NicholasUnruh/rv32i-pipeline/results/10-icache/crosscheck.csv

program | sets | ways | line | lookups | rtl_fills | sim_misses | match
aha-mont64 | 64 | 1 | 16 | 4107155 | 113354 | 113354 | True
crc32 | 64 | 1 | 16 | 1752121 | 35 | 35 | True
edn | 64 | 1 | 16 | 31167761 | 10839 | 10839 | True
huffbench | 64 | 1 | 16 | 962891 | 1626 | 1626 | True
matmult-int | 64 | 1 | 16 | 13467617 | 370 | 370 | True
nettle-aes | 64 | 1 | 16 | 1210518 | 53225 | 53225 | True
nettle-sha256 | 64 | 1 | 16 | 999236 | 864961 | 864961 | True
nsichneu | 64 | 1 | 16 | 1005386 | 846428 | 846428 | True
picojpeg | 64 | 1 | 16 | 1580615 | 201684 | 201684 | True
qrduino | 64 | 1 | 16 | 2671219 | 58655 | 58655 | True
sglib-combined | 64 | 1 | 16 | 1117938 | 82550 | 82550 | True
slre | 64 | 1 | 16 | 859405 | 231622 | 231622 | True
statemate | 64 | 1 | 16 | 526843 | 400952 | 400952 | True
ud | 64 | 1 | 16 | 2616494 | 458597 | 458597 | True
aha-mont64 | 64 | 2 | 16 | 4110121 | 29432 | 29432 | True
crc32 | 64 | 2 | 16 | 1752121 | 32 | 32 | True
edn | 64 | 2 | 16 | 31167762 | 6626 | 6626 | True
huffbench | 64 | 2 | 16 | 962881 | 736 | 736 | True
matmult-int | 64 | 2 | 16 | 13467616 | 81 | 81 | True
nettle-aes | 64 | 2 | 16 | 1210519 | 39499 | 39499 | True
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
