NicholasUnruh/rv32i-pipeline/results/10-icache/embench-16k.csv

program | sets_bits | ways | offset_bits | isets_bits | iways | latency | cycles | instret | fetches | fills | daccesses | dhits | dmisses | dwritebacks | fill | loaduse | flush | icmiss | dcmiss
aha-mont64 | 6 | 2 | 6 | 7 | 8 | 10 | 11840488 | 10982238 | 11409942 | 186 | 76884 | 76878 | 6 | 0 | 4 | 0 | 855434 | 2638 | 174
crc32 | 6 | 2 | 6 | 7 | 8 | 10 | 5956576 | 5955176 | 5955386 | 32 | 525515 | 525497 | 18 | 0 | 4 | 0 | 416 | 458 | 522
edn | 6 | 2 | 6 | 7 | 8 | 10 | 81112188 | 74279815 | 77693675 | 179 | 1053320 | 1053250 | 70 | 0 | 4 | 288 | 6827752 | 2299 | 2030
huffbench | 6 | 2 | 6 | 7 | 8 | 10 | 2675488 | 2334445 | 2422109 | 166 | 638715 | 637743 | 972 | 688 | 4 | 123543 | 175348 | 2264 | 39884
matmult-int | 6 | 2 | 6 | 7 | 8 | 10 | 34554914 | 29142273 | 31835435 | 80 | 1227676 | 1227015 | 661 | 333 | 4 | 399 | 5386340 | 1068 | 24830
nettle-aes | 6 | 2 | 6 | 7 | 8 | 10 | 4844648 | 4472479 | 4510356 | 259 | 873304 | 863812 | 9492 | 1040 | 4 | 0 | 75774 | 3443 | 292948
nettle-sha256 | 6 | 2 | 6 | 7 | 8 | 10 | 3910407 | 3863328 | 3874341 | 461 | 425849 | 425822 | 27 | 0 | 4 | 17135 | 22038 | 7119 | 783
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
