NicholasUnruh/rv32i-pipeline/results/10-icache/embench-base.csv

program | sets_bits | ways | offset_bits | isets_bits | iways | latency | cycles | instret | fetches | fills | daccesses | dhits | dmisses | dwritebacks | fill | loaduse | flush | icmiss | dcmiss
aha-mont64 | 6 | 2 | 6 | 6 | 1 | 10 | 13596411 | 10982238 | 11399330 | 113354 | 76884 | 76878 | 6 | 0 | 4 | 0 | 855434 | 1758561 | 174
crc32 | 6 | 2 | 6 | 6 | 1 | 10 | 5956634 | 5955176 | 5955386 | 35 | 525515 | 525497 | 18 | 0 | 4 | 0 | 416 | 516 | 522
edn | 6 | 2 | 6 | 6 | 1 | 10 | 81268389 | 74279815 | 77693062 | 10839 | 1053320 | 1053250 | 70 | 0 | 4 | 288 | 6827752 | 158500 | 2030
huffbench | 6 | 2 | 6 | 6 | 1 | 10 | 2696911 | 2334445 | 2422024 | 1626 | 638715 | 637743 | 972 | 688 | 4 | 123521 | 175348 | 23709 | 39884
matmult-int | 6 | 2 | 6 | 6 | 1 | 10 | 34558785 | 29142273 | 31835434 | 370 | 1227676 | 1227015 | 661 | 333 | 4 | 399 | 5386340 | 4939 | 24830
nettle-aes | 6 | 2 | 6 | 6 | 1 | 10 | 5654645 | 4472479 | 4509331 | 53225 | 873304 | 863812 | 9492 | 1040 | 4 | 0 | 75774 | 813440 | 292948
nettle-sha256 | 6 | 2 | 6 | 6 | 1 | 10 | 17719530 | 3863328 | 3872430 | 864961 | 425849 | 425822 | 27 | 0 | 4 | 16660 | 22038 | 13816717 | 783
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
