NicholasUnruh/rv32i-pipeline/results/10-icache/sweep.csv

program | size | ways | line | policy | accesses | misses | writebacks | stall | cycles | instret | cpi
aha-mont64 | 256 | 1 | 16 | lru | 4107155 | 160017 | 0 | 2560272 | 14398122 | 10982238 | 1.31104
aha-mont64 | 256 | 1 | 16 | srrip | 4107155 | 160017 | 0 | 2560272 | 14398122 | 10982238 | 1.31104
aha-mont64 | 256 | 1 | 16 | brrip | 4107155 | 160017 | 0 | 2560272 | 14398122 | 10982238 | 1.31104
aha-mont64 | 256 | 1 | 32 | lru | 4107155 | 114158 | 0 | 2283160 | 14121010 | 10982238 | 1.28580
aha-mont64 | 256 | 1 | 32 | srrip | 4107155 | 114158 | 0 | 2283160 | 14121010 | 10982238 | 1.28580
aha-mont64 | 256 | 1 | 32 | brrip | 4107155 | 114158 | 0 | 2283160 | 14121010 | 10982238 | 1.28580
aha-mont64 | 256 | 1 | 64 | lru | 4107155 | 80206 | 0 | 2245768 | 14083618 | 10982238 | 1.28240
aha-mont64 | 256 | 1 | 64 | srrip | 4107155 | 80206 | 0 | 2245768 | 14083618 | 10982238 | 1.28240
aha-mont64 | 256 | 1 | 64 | brrip | 4107155 | 80206 | 0 | 2245768 | 14083618 | 10982238 | 1.28240
aha-mont64 | 256 | 2 | 16 | lru | 4107155 | 152380 | 0 | 2438080 | 14275930 | 10982238 | 1.29991
aha-mont64 | 256 | 2 | 16 | srrip | 4107155 | 150255 | 0 | 2404080 | 14241930 | 10982238 | 1.29681
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
