NicholasUnruh/rv32i-pipeline/results/6-dcache/geometry.csv

program | sets_bits | ways | offset_bits | latency | cycles | instret | fetches | fills | daccesses | dhits | dmisses | dwritebacks
bench | 1 | 1 | 3 | 10 | 77670 | 35324 | 36132 | 138 | 6694 | 4403 | 2291 | 1643
bench | 1 | 1 | 4 | 10 | 66452 | 35324 | 36133 | 138 | 6694 | 5315 | 1379 | 922
bench | 1 | 2 | 3 | 10 | 74221 | 35324 | 36132 | 138 | 6694 | 4614 | 2080 | 1549
bench | 3 | 2 | 4 | 10 | 43324 | 35324 | 36132 | 138 | 6694 | 6474 | 220 | 149
bench | 2 | 4 | 5 | 10 | 39561 | 35324 | 36130 | 138 | 6694 | 6668 | 26 | 10
bench | 5 | 2 | 4 | 10 | 39561 | 35324 | 36130 | 138 | 6694 | 6654 | 40 | 0
