NicholasUnruh/rv32i-pipeline/(commit log)

2026-11-12 Pipeline the core into five stages
2026-11-12 Add pipeline probe, CPI stack and resource figures
    A testbench probe tags every bubble with its cause and traces each stage;
    scripts turn it and the Quartus reports into figures under docs/img.
2026-11-12 Add a set-associative write-back data cache
    [geometry.csv, latency.csv, riscv-tests.csv]
2026-11-12 Check the data cache against cache-sim per access
    [crosscheck.csv, mutants.csv]
2026-11-12 Run Embench-IoT and pick an 8 KB data cache
    [crosscheck.csv, embench-16k.csv, embench-1k.csv, embench-8k.csv, sweep.csv]
2026-11-12 Generalize the cache sweep to either cache
    [sweep.csv]
2026-11-12 Size the I-cache from Embench traces with cache-sim
    [crosscheck.csv, embench-16k.csv, embench-base.csv, sweep.csv]
